FrancDuarteMar/Dig333-Sprinkler/images/designs/banana-plug.jpg

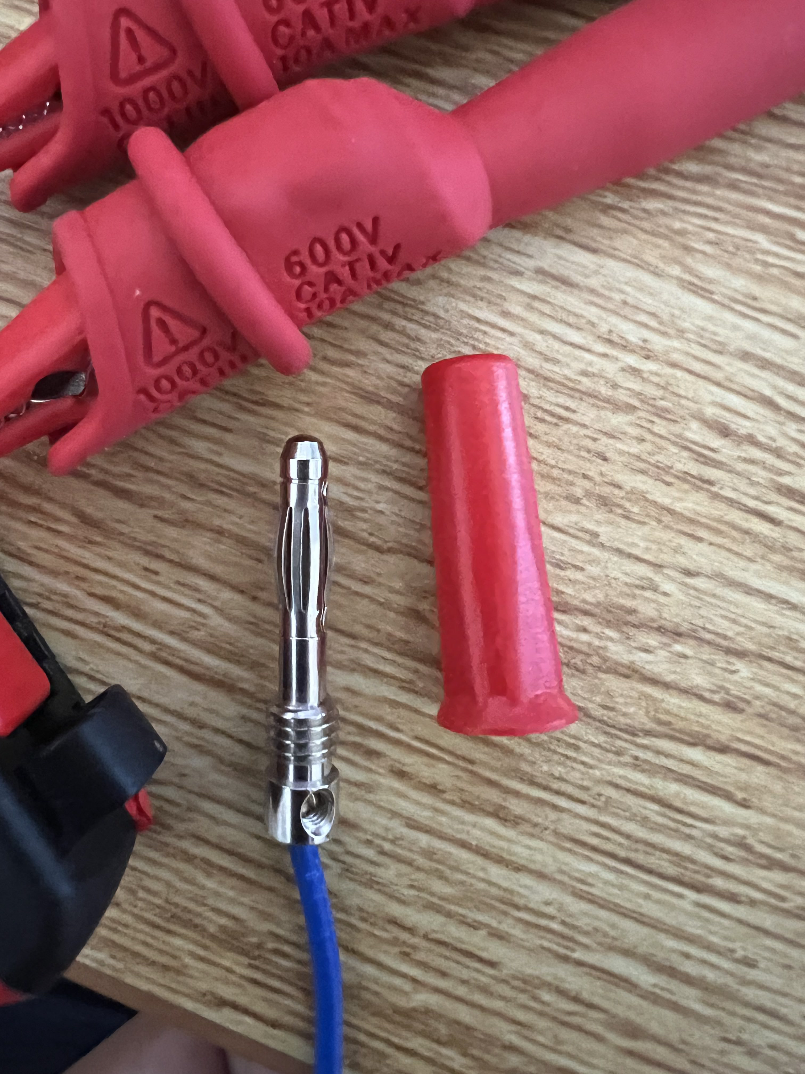
images/designs/banana-plug.jpg
