FrancDuarteMar/Dig333-Sprinkler/images/designs/ferrule-crimped.jpg

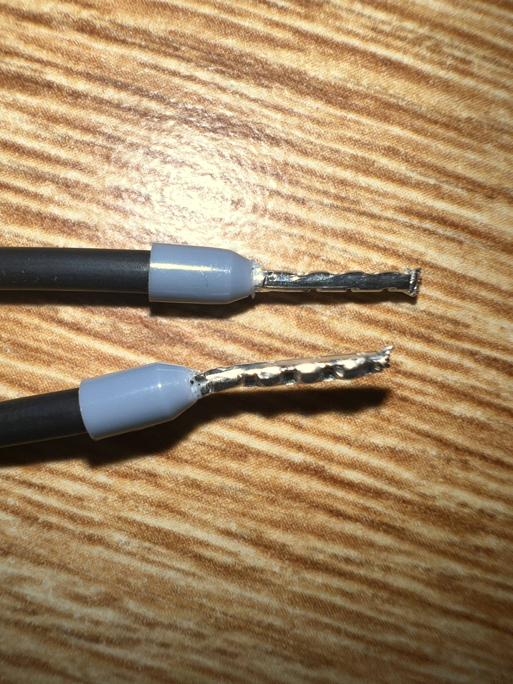
images/designs/ferrule-crimped.jpg
