FrancDuarteMar/Dig333-Sprinkler/images/designs/ferrule-crimping.jpg

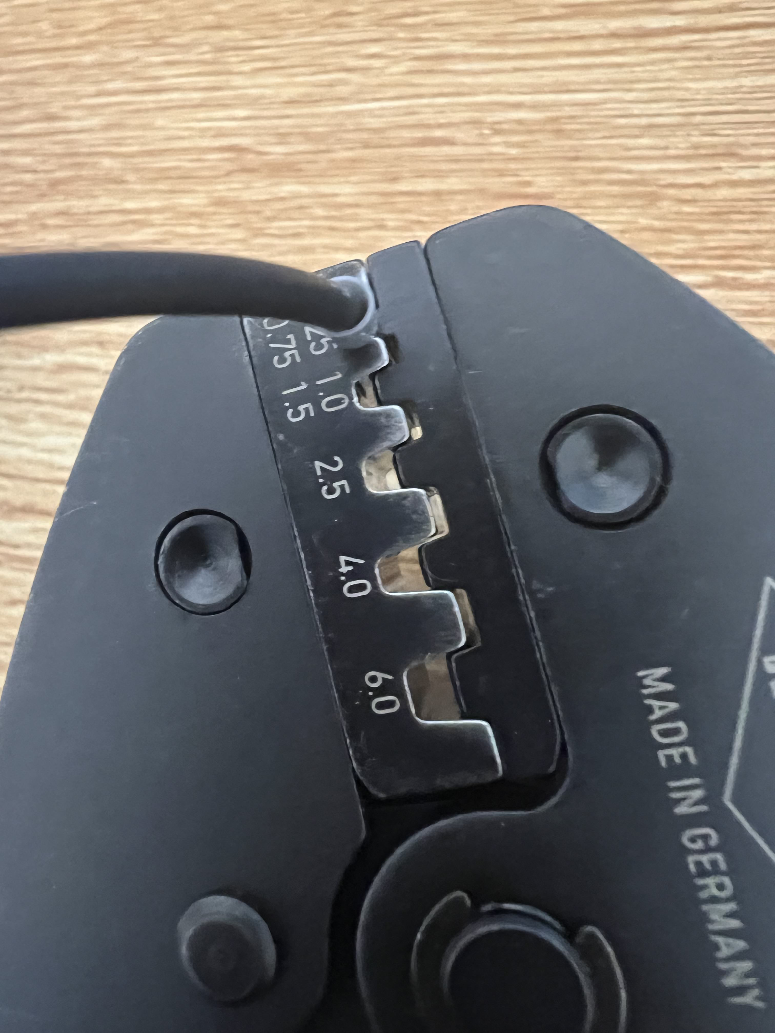
images/designs/ferrule-crimping.jpg
