FrancDuarteMar/Dig333-Sprinkler/images/designs/remote-view-3.jpg

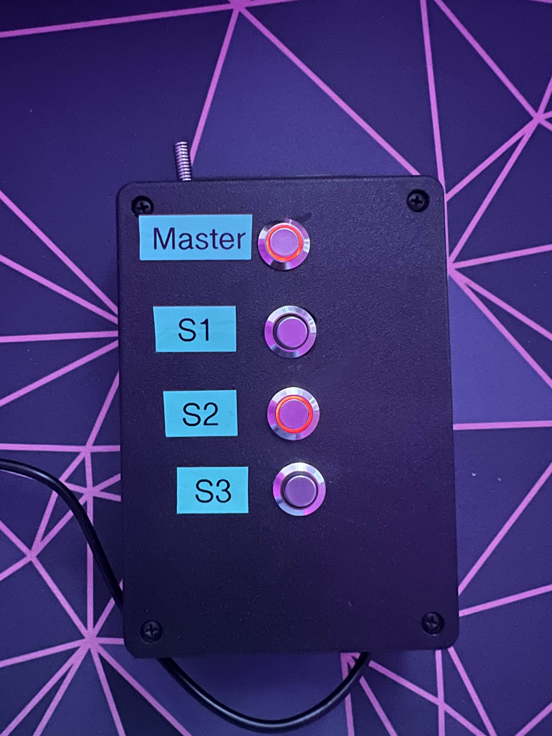
images/designs/remote-view-3.jpg
