FrancDuarteMar/Dig333-Sprinkler/images/designs/controller-2803a-wiring-2.jpg

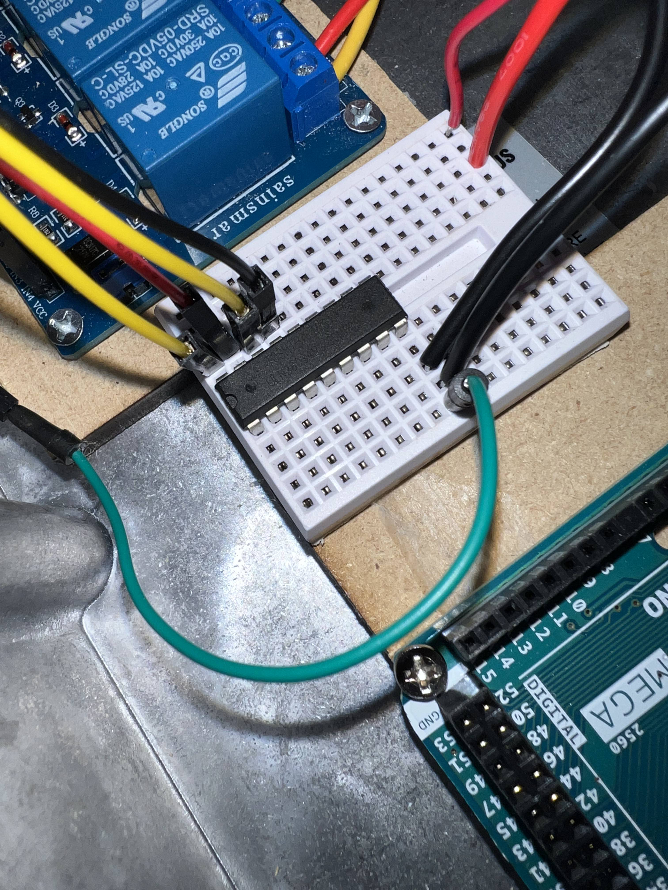
images/designs/controller-2803a-wiring-2.jpg
