FrancDuarteMar/Dig333-Sprinkler/images/designs/controller-2803a-wiring.jpg

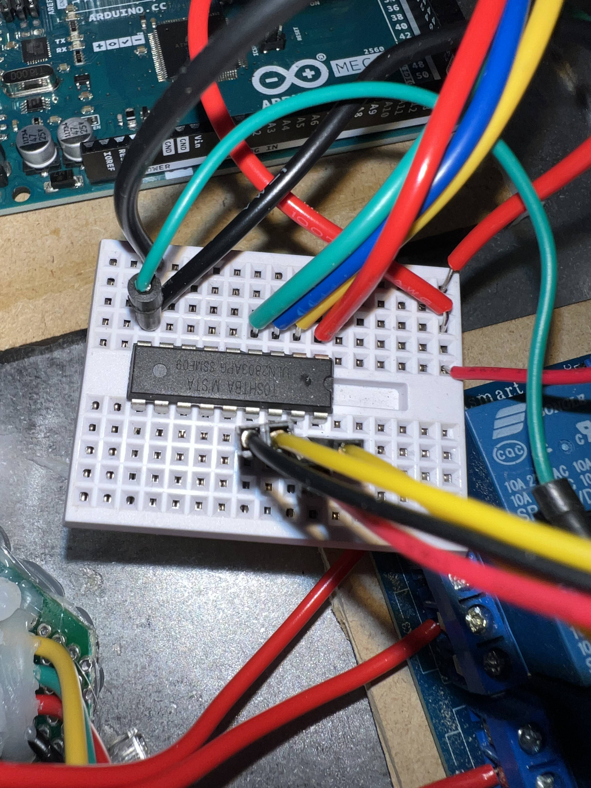
images/designs/controller-2803a-wiring.jpg
