FrancDuarteMar/Dig333-Sprinkler/images/designs/controller-relayboard-wiring-2.jpg

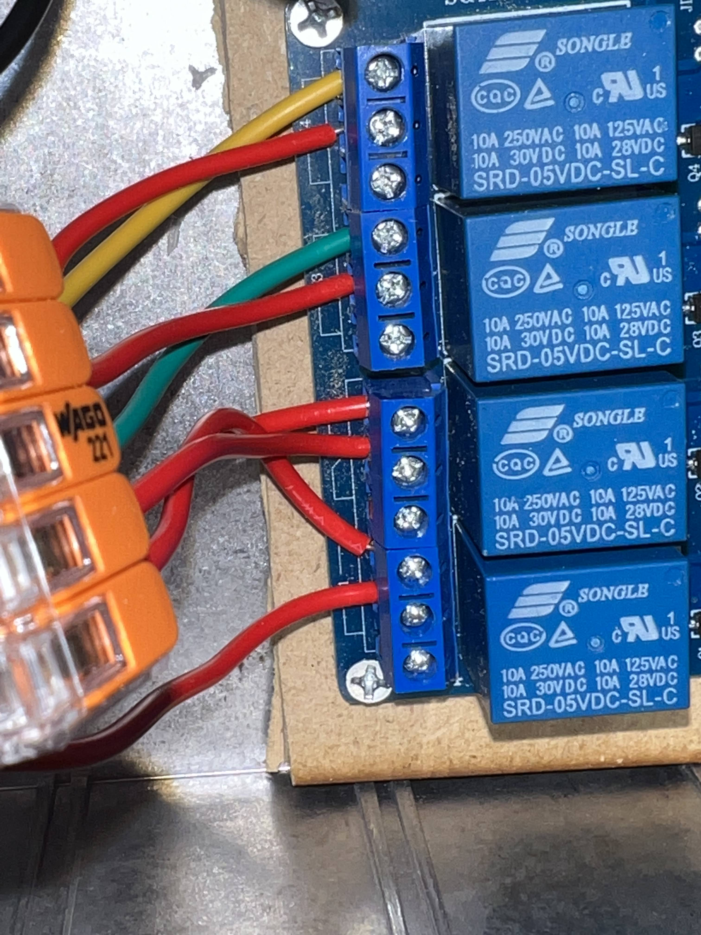
images/designs/controller-relayboard-wiring-2.jpg
