FrancDuarteMar/Dig333-Sprinkler/images/designs/progress/test-pico-wiring.jpg

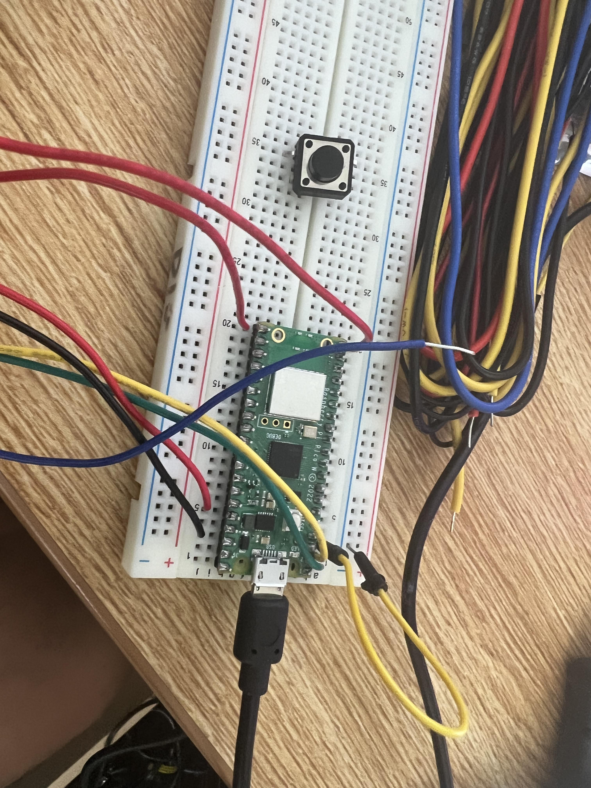
images/designs/progress/test-pico-wiring.jpg
