FrancDuarteMar/Dig333-Sprinkler/images/designs/remote-wiring.jpg

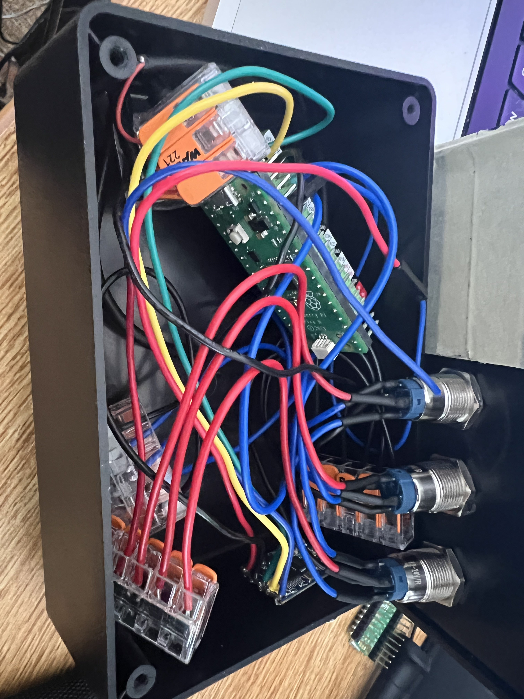
images/designs/remote-wiring.jpg
