FrancDuarteMar/Dig333-Sprinkler/images/designs/progress/test-remote-2.jpg

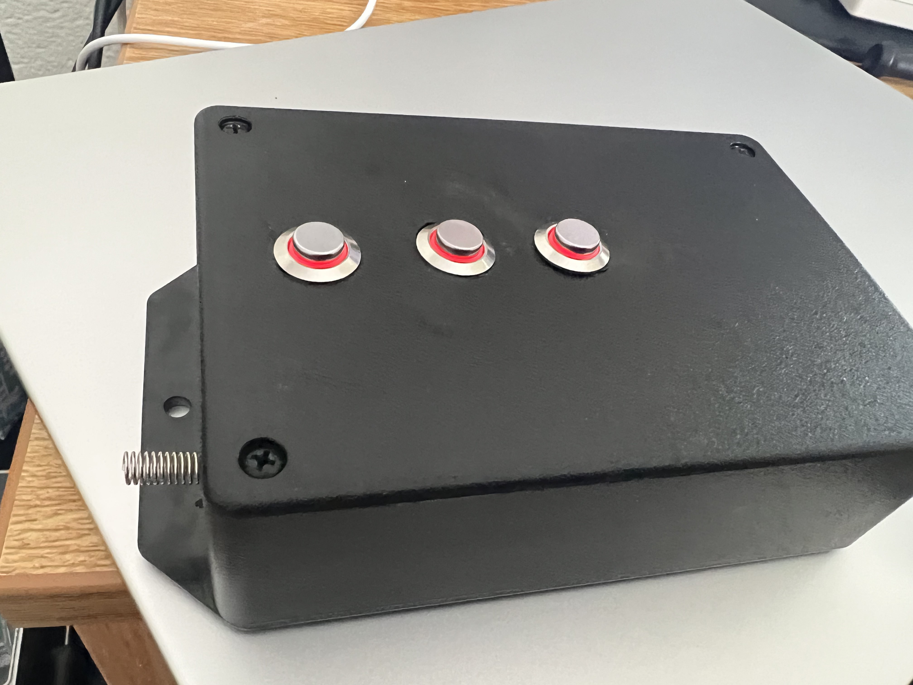
images/designs/progress/test-remote-2.jpg
