FrancDuarteMar/Dig333-Sprinkler/images/designs/progress/test-remote.jpg

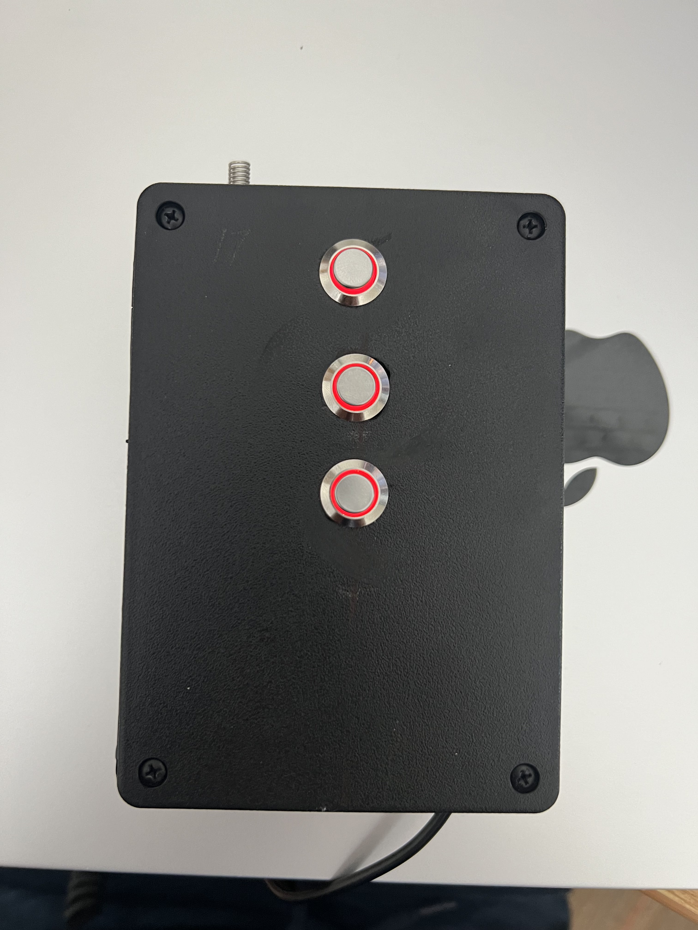
images/designs/progress/test-remote.jpg
