FrancDuarteMar/Dig333-Sprinkler/images/designs/progress/test-views-2.jpg

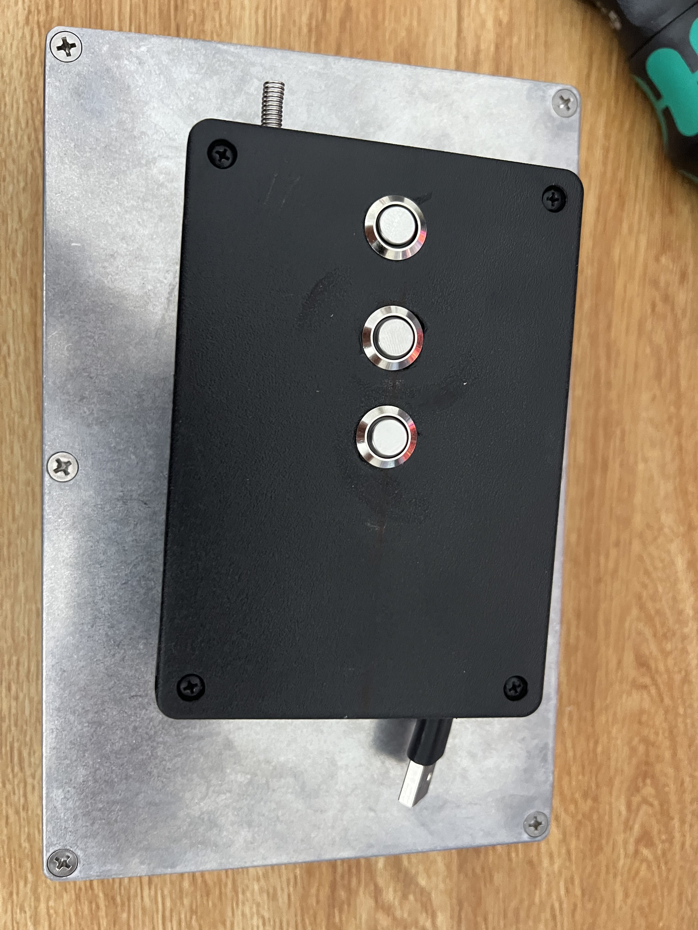
images/designs/progress/test-views-2.jpg
