FrancDuarteMar/Dig333-Sprinkler/images/designs/progress/test-views-3.jpg

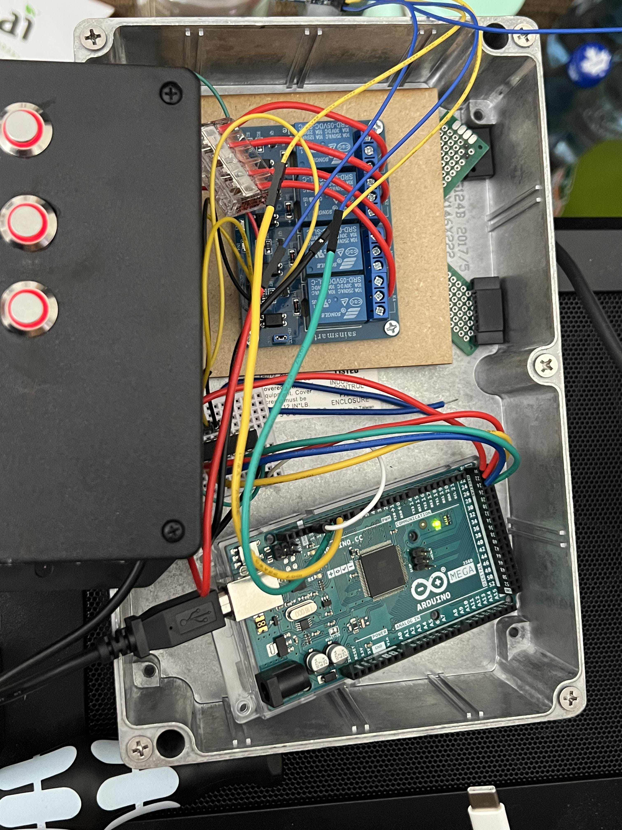
images/designs/progress/test-views-3.jpg
