FrancDuarteMar/Dig333-Sprinkler/images/designs/progress/test-views.jpg

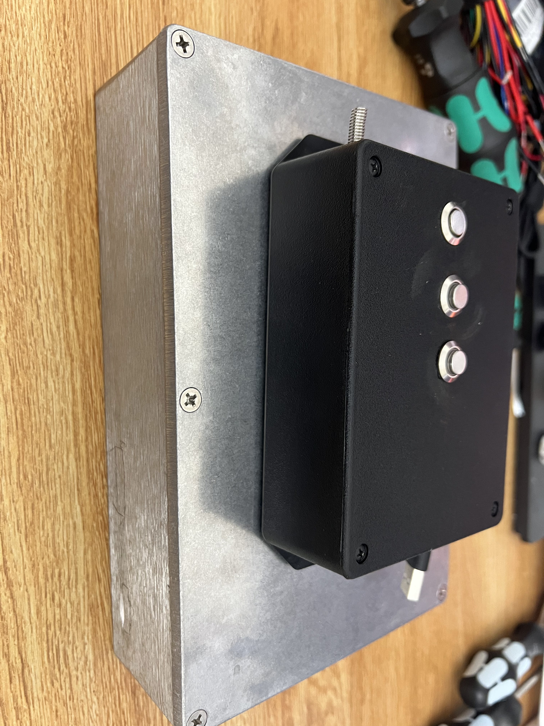
images/designs/progress/test-views.jpg
