FrancDuarteMar/Dig333-Sprinkler/(commit log)

2023-04-12 Switched buffer from text to array
2023-04-12 Updated print statement
2023-05-03 Added wiring instructions
2023-05-03 Renamed prototype code folder
