FrancDuarteMar/Dig333-Sprinkler/images/designs/remote-view-2.jpg

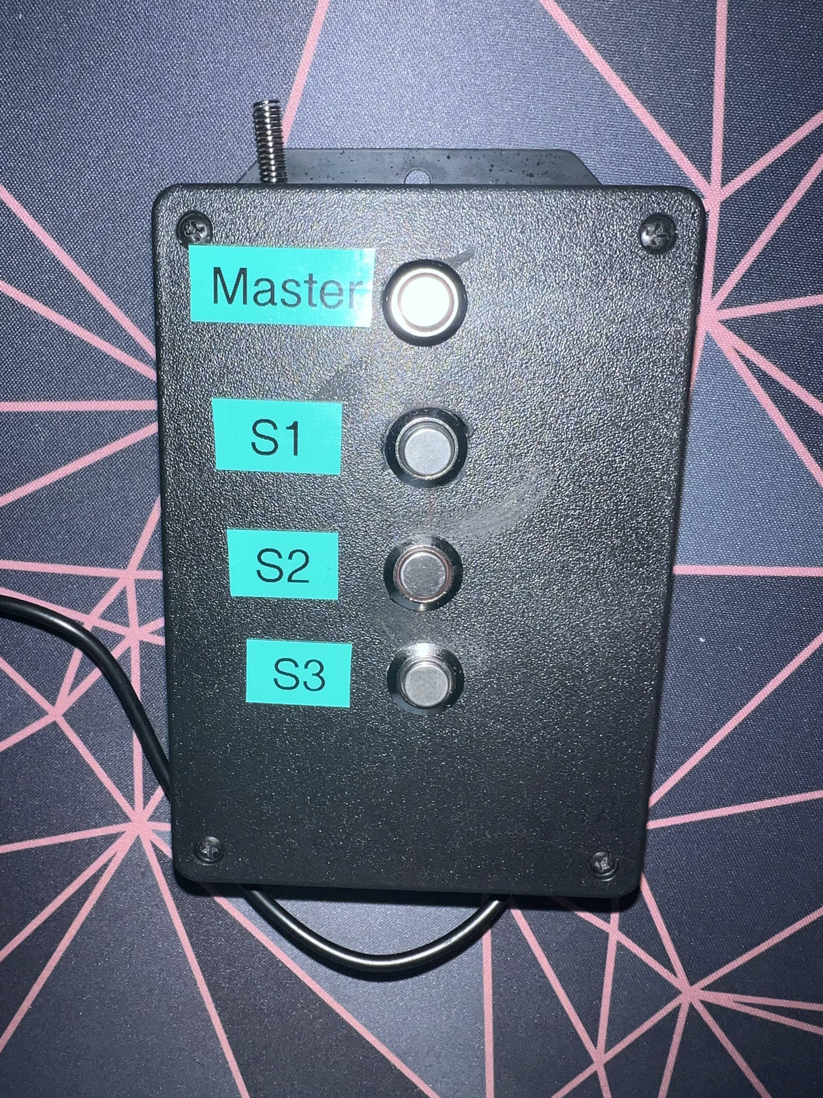
images/designs/remote-view-2.jpg
