FrancDuarteMar/Dig333-Sprinkler/images/designs/remote-view.jpg

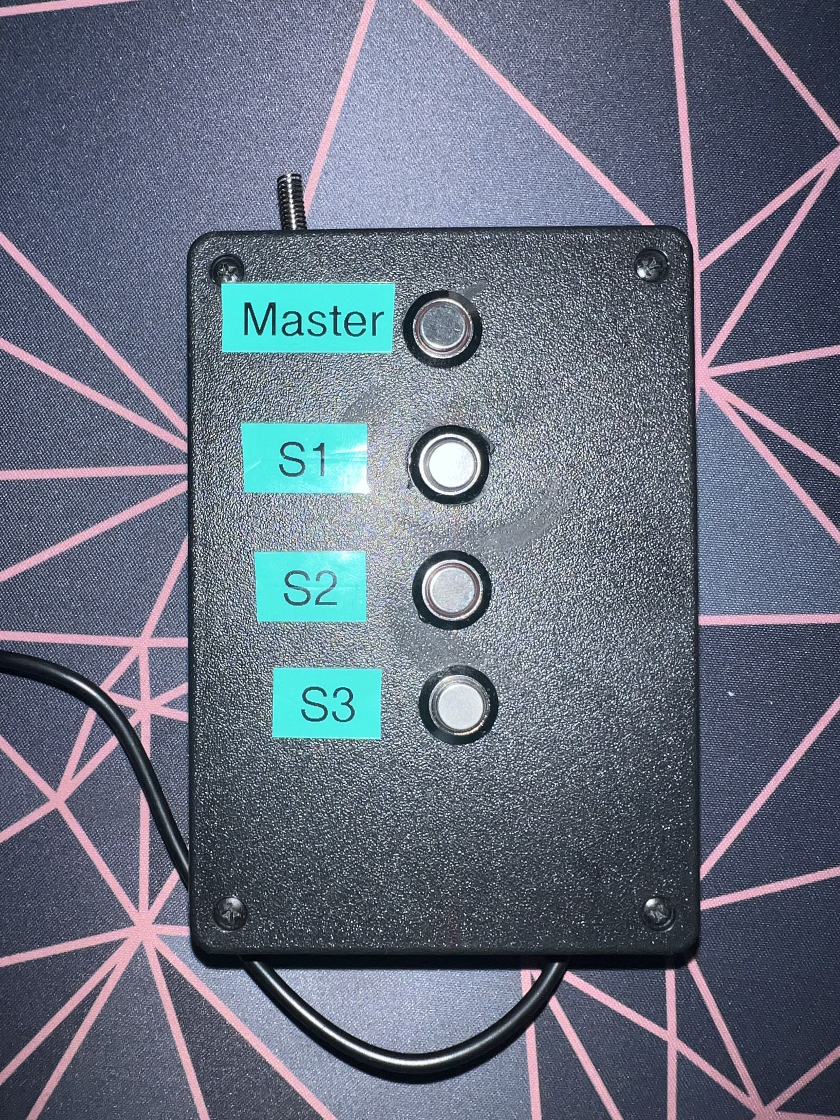
images/designs/remote-view.jpg
