FrancDuarteMar/Dig333-Sprinkler/images/designs/progress/test-controller-wiring-2.jpg

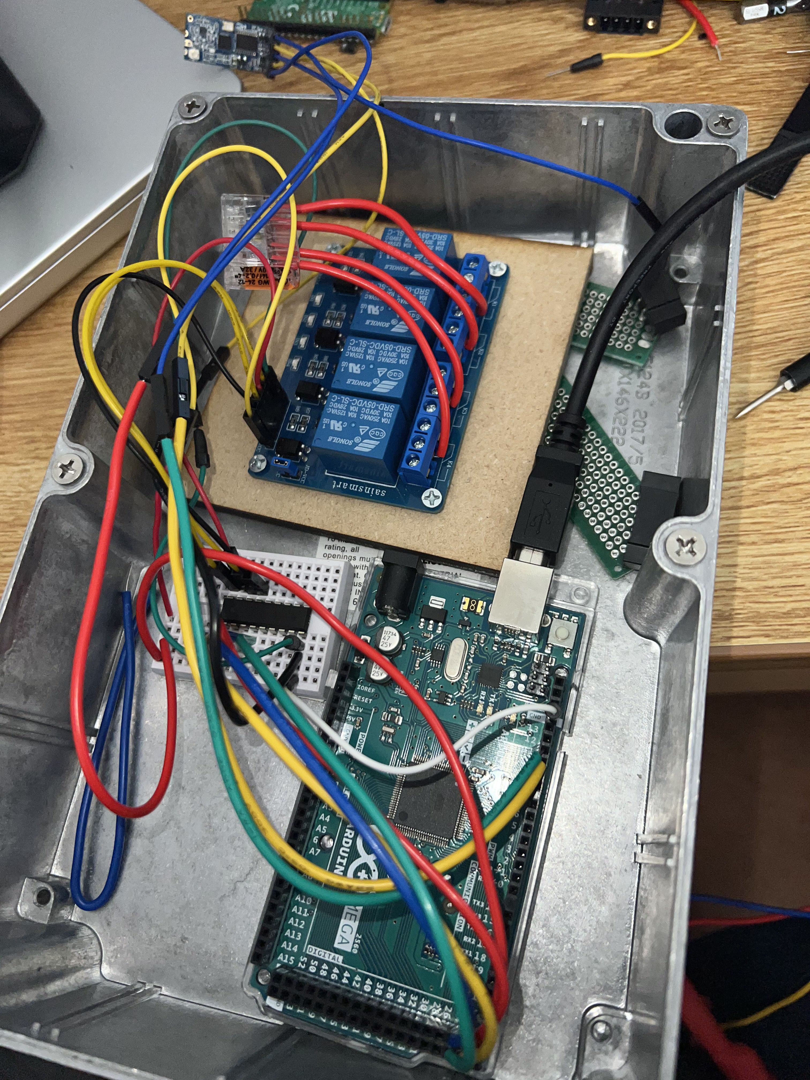
images/designs/progress/test-controller-wiring-2.jpg
