FrancDuarteMar/Dig333-Sprinkler/images/designs/progress/test-controller-wiring.jpg

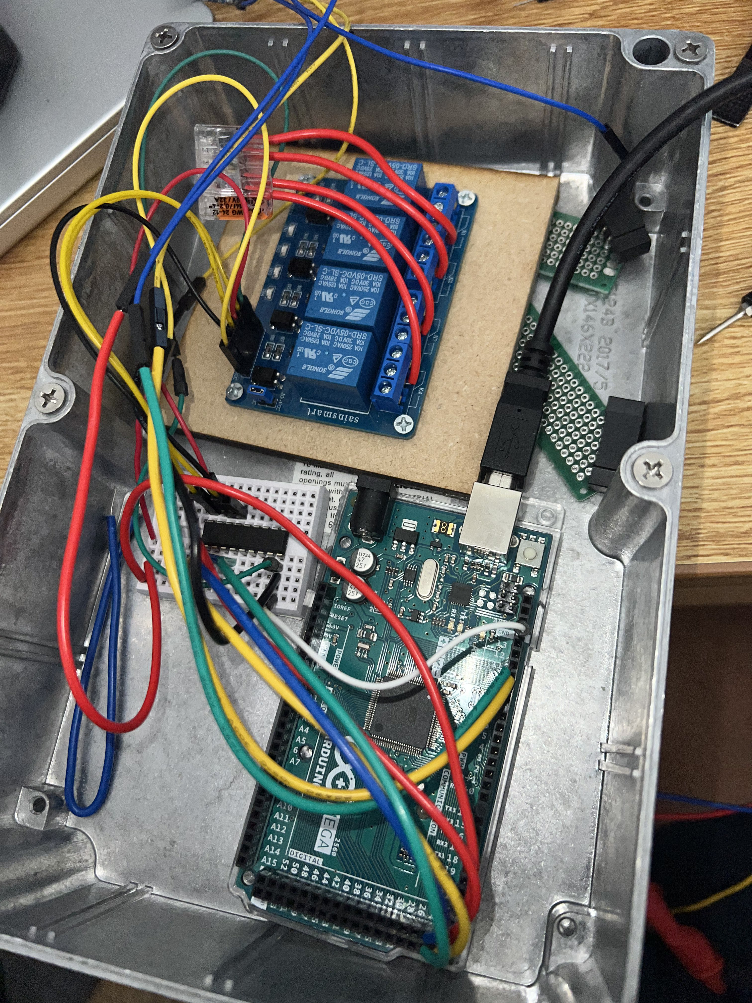
images/designs/progress/test-controller-wiring.jpg
