FrancDuarteMar/Dig333-Sprinkler/images/designs/IMG_2869.jpg

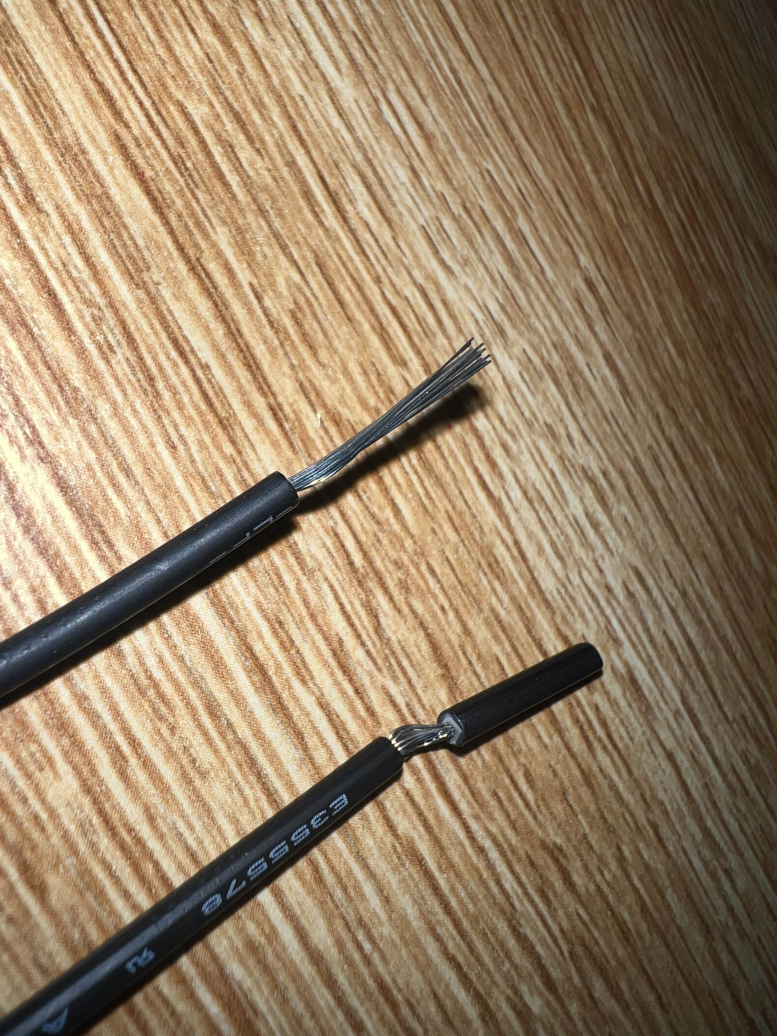
[picture p13: images/designs/stranded-wire.jpg]
images/designs/IMG_2869.jpg
