FrancDuarteMar/Dig333-Sprinkler/images/designs/IMG_2868.jpg

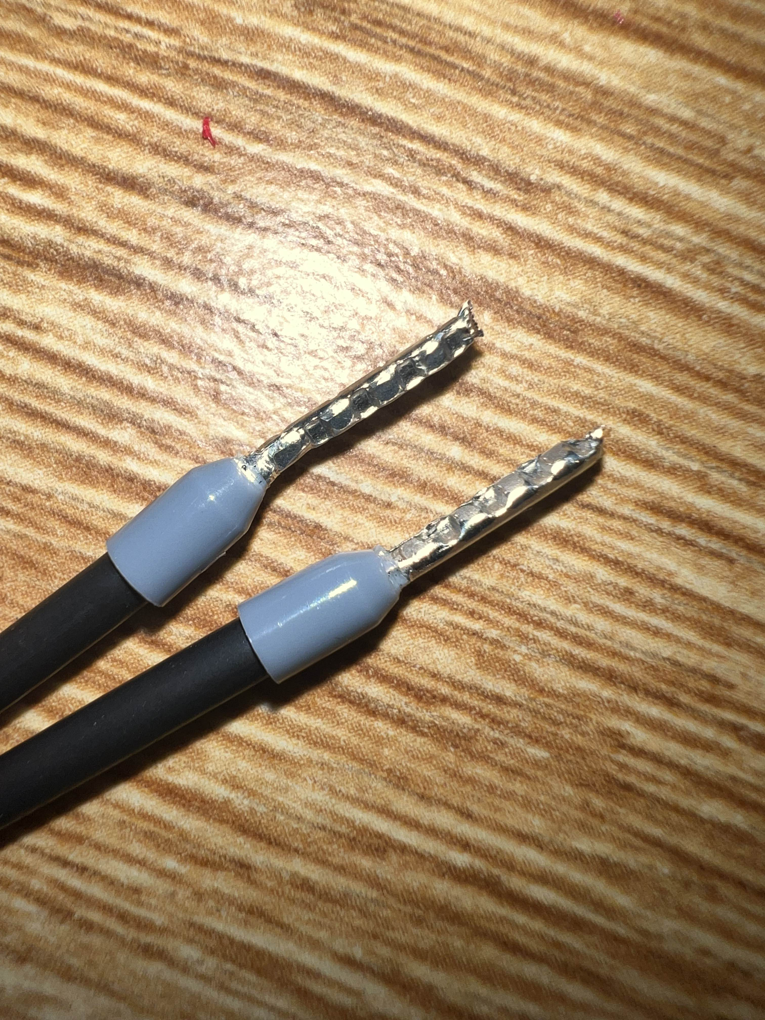
[picture p15: images/designs/ferrule-crimped-2.jpg]
images/designs/IMG_2868.jpg
