FrancDuarteMar/Dig333-Sprinkler/images/designs/IMG_2902.jpg

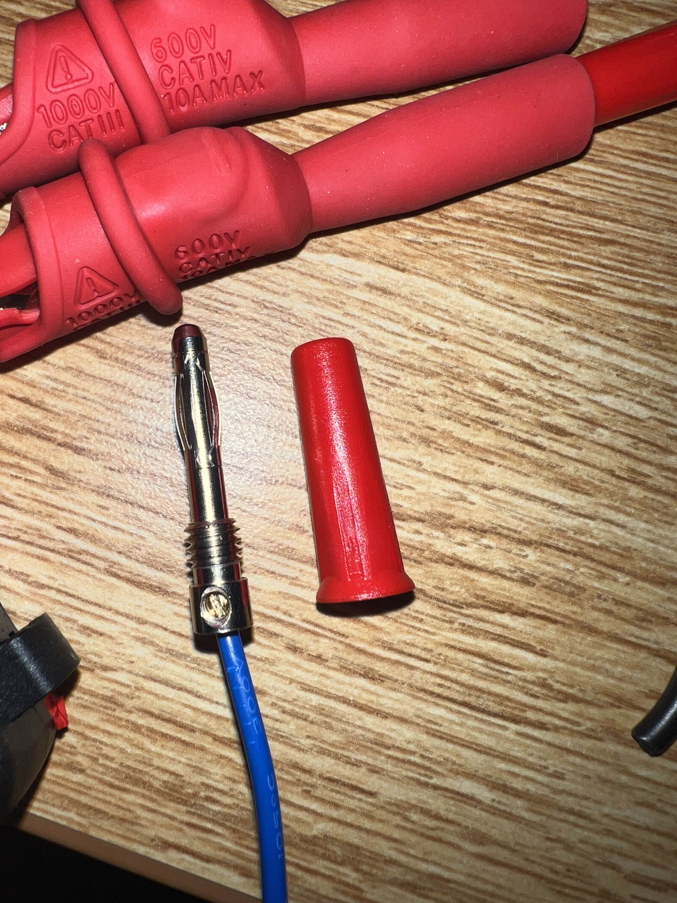
[picture p16: images/designs/banana-plug-2.jpg]
images/designs/IMG_2902.jpg
