FrancDuarteMar/Dig333-Sprinkler/images/designs/IMG_2953.jpg

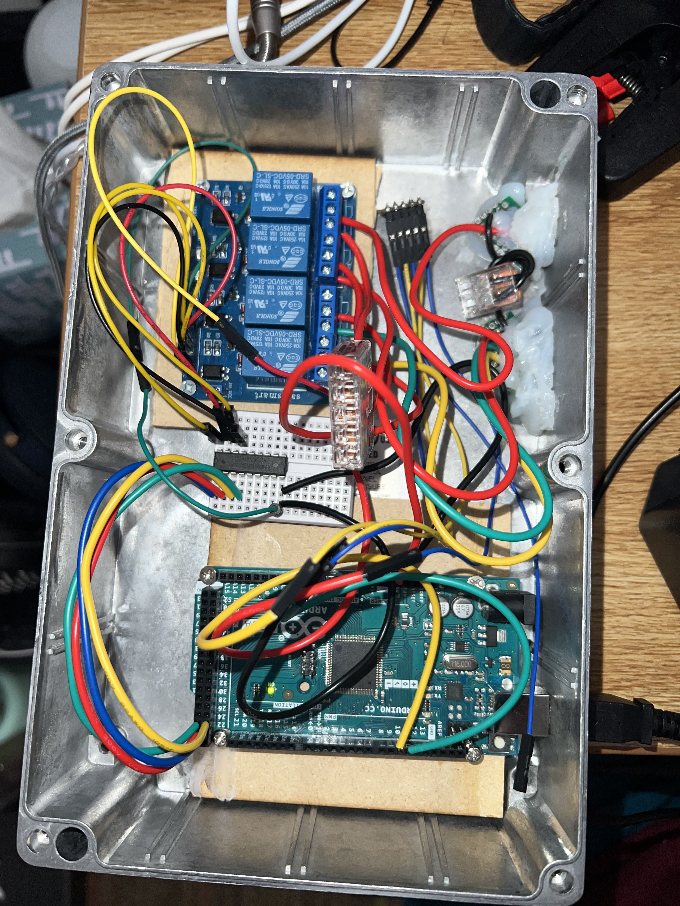
[picture p24: images/designs/controller-wiring-2.jpg]
images/designs/IMG_2953.jpg
