FrancDuarteMar/Dig333-Sprinkler/images/designs/IMG_2894.jpg

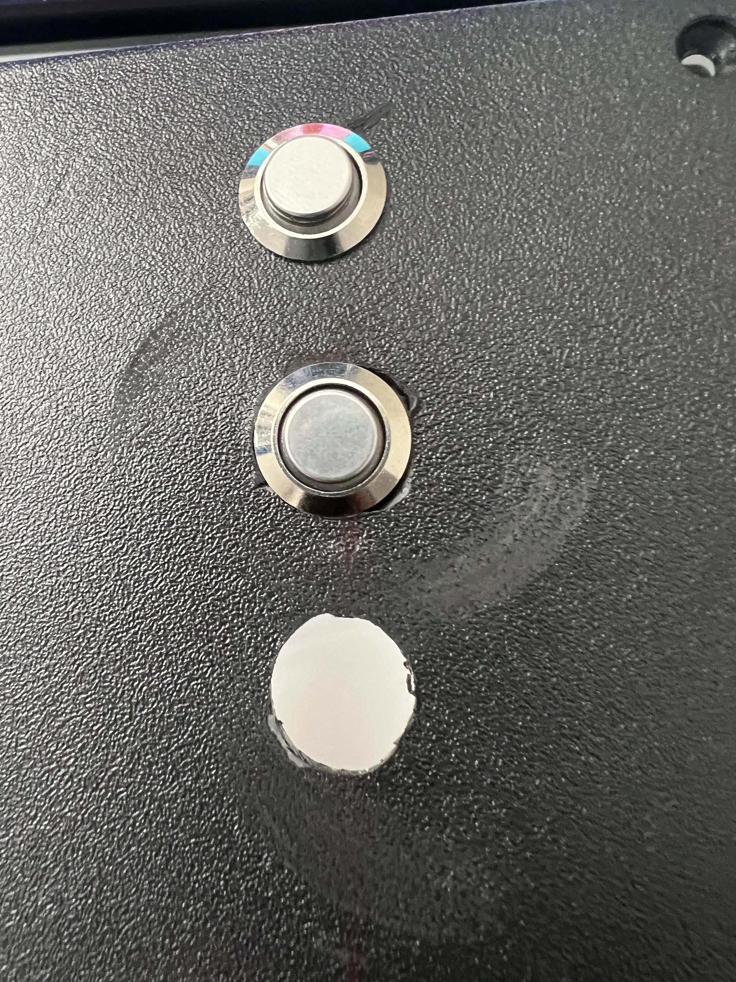
[picture p25: images/designs/button-progress-2.jpg]
images/designs/IMG_2894.jpg
