FrancDuarteMar/Dig333-Sprinkler/images/designs/alligator-clips.jpg

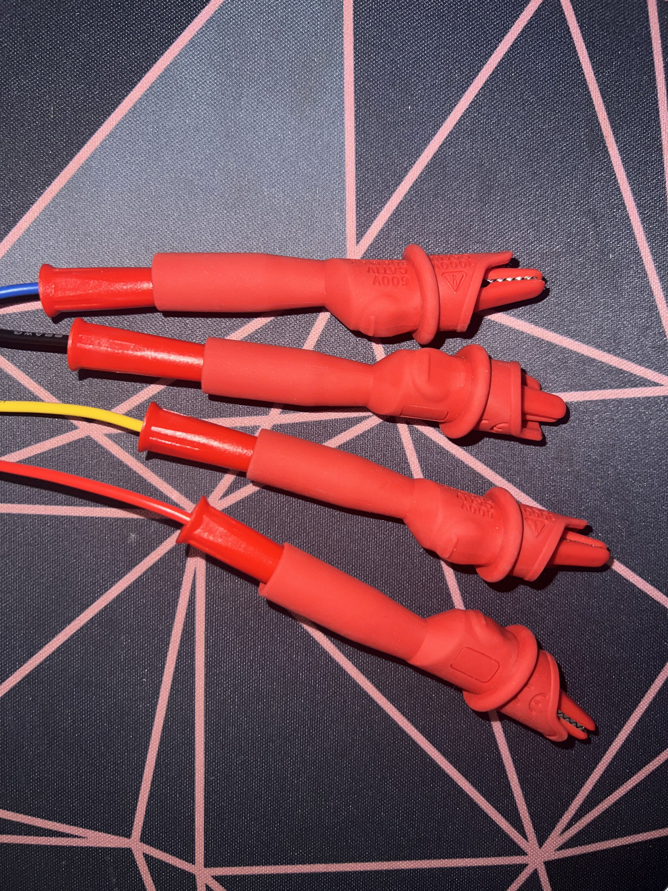
[picture p29: images/designs/alligator-clips.jpg]
images/designs/alligator-clips.jpg
