FrancDuarteMar/Dig333-Sprinkler/images/designs/connectors.jpg

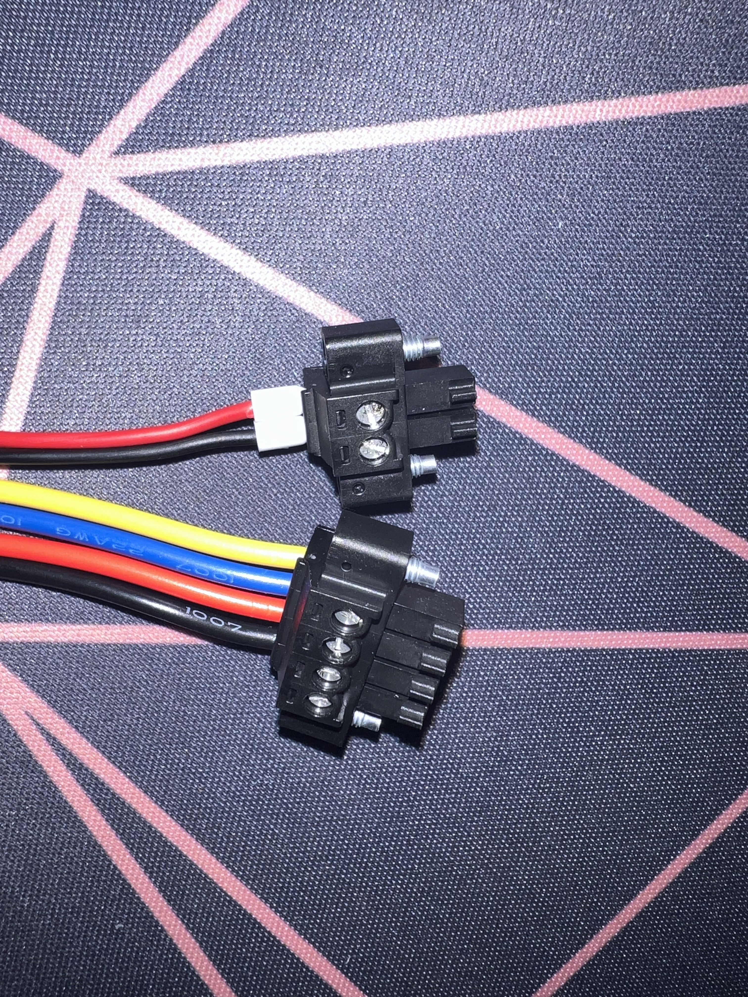
[picture p30: images/designs/connectors.jpg]
images/designs/connectors.jpg
