FrancDuarteMar/Dig333-Sprinkler/images/designs/progress/test-pi-433-2.jpg

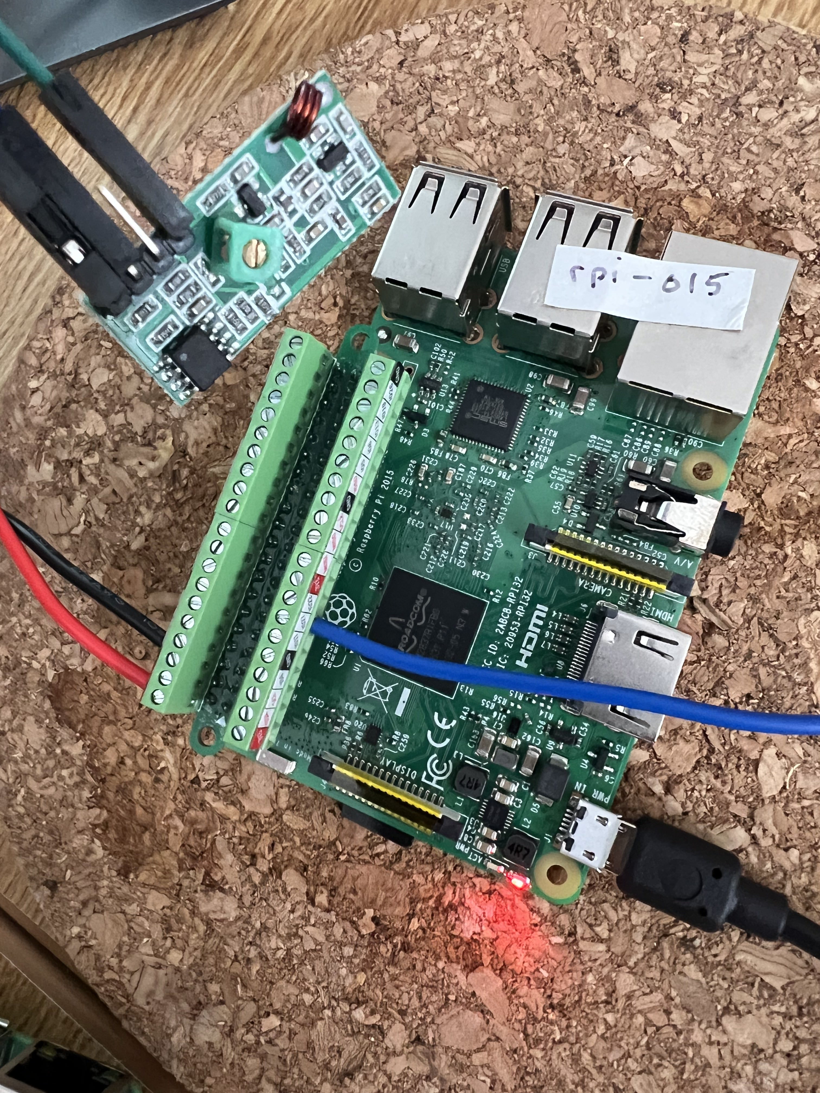
images/designs/progress/test-pi-433-2.jpg
