FrancDuarteMar/Dig333-Sprinkler/images/designs/progress/test-pi-433.jpg

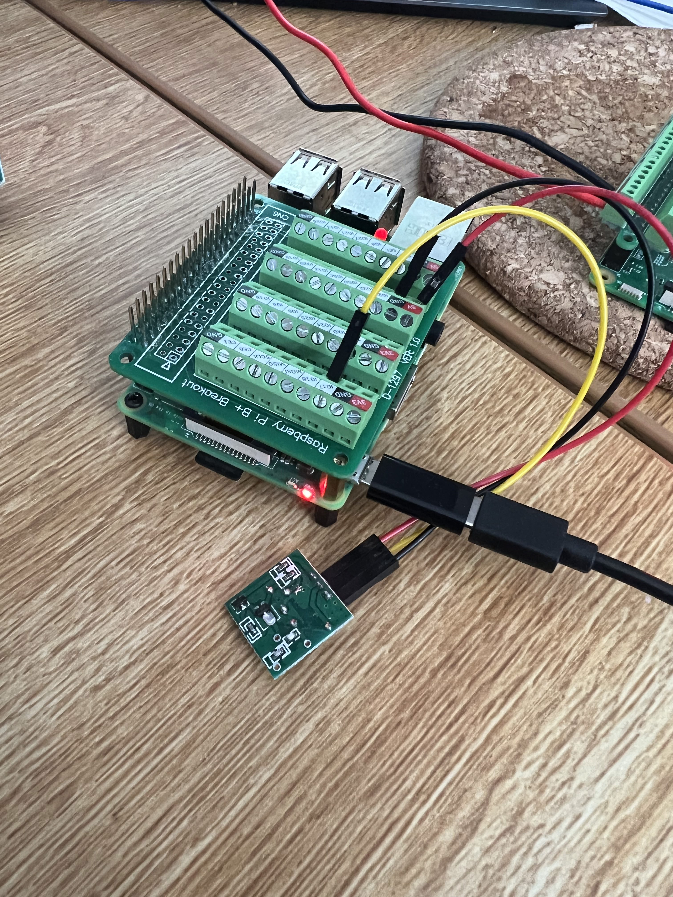
images/designs/progress/test-pi-433.jpg
