FrancDuarteMar/Dig333-Sprinkler/images/designs/progress/test-pi-nr-2.jpg

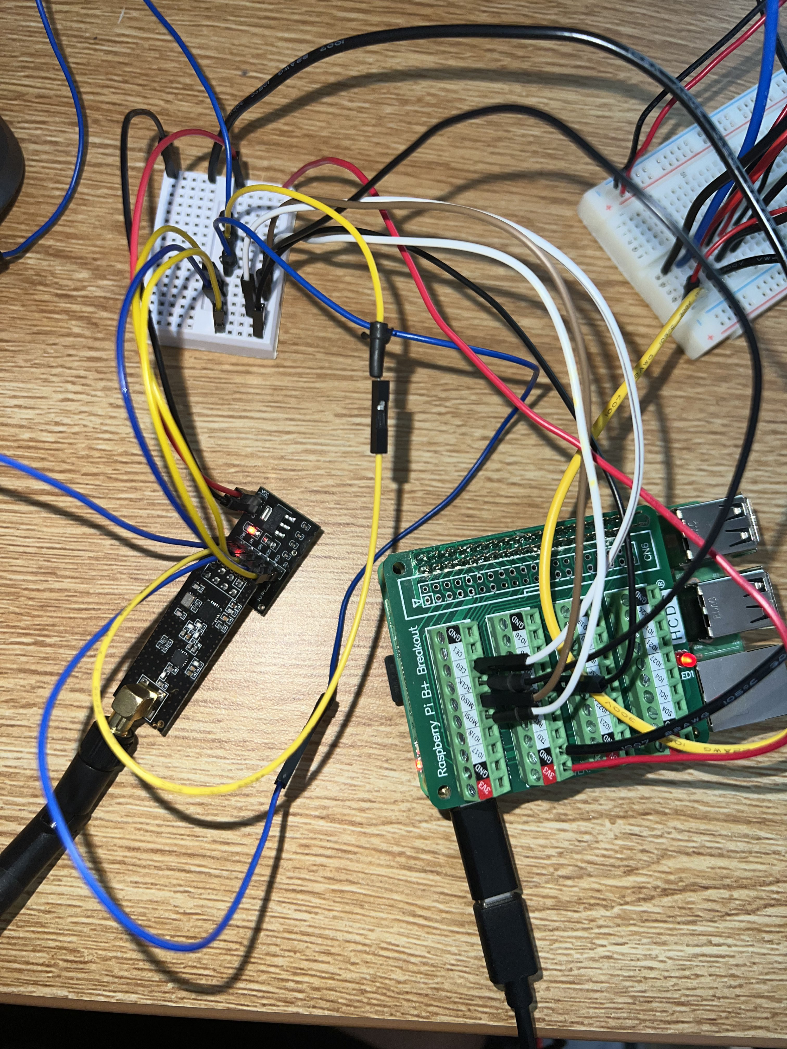
images/designs/progress/test-pi-nr-2.jpg
