FrancDuarteMar/Dig333-Sprinkler/images/designs/progress/test-pi-nr.jpg

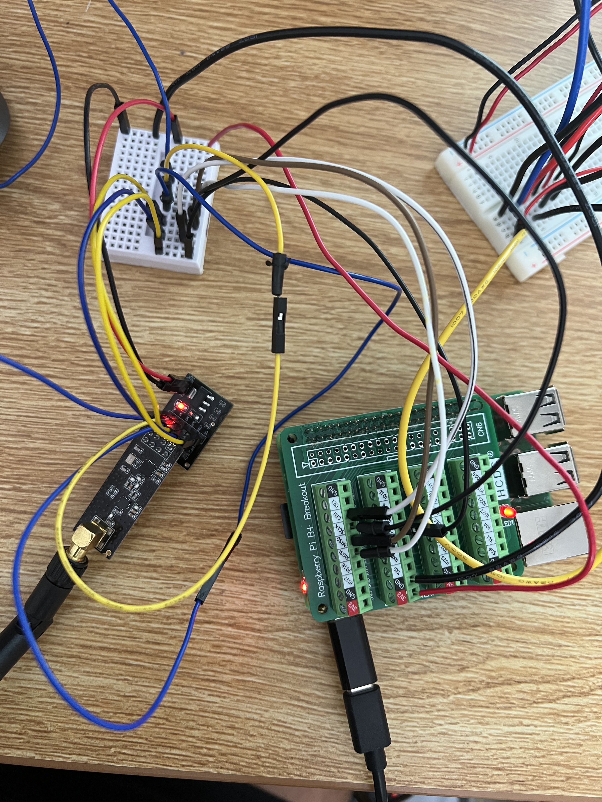
images/designs/progress/test-pi-nr.jpg
